mihizenithv/theremin-ieee-paper-repo/theremin-paper/docs/presentation_original.pdf

# THEREMIN

# Circuit

Using a 9V dc source and Pure Analog implementation

## IN SHORT:-

## “The circuit uses a CD4093-based RC oscillator with a potentiometer for frequency control, an op-amp for mixing and amplification, and an LM386 to drive an 8Ω speaker.”

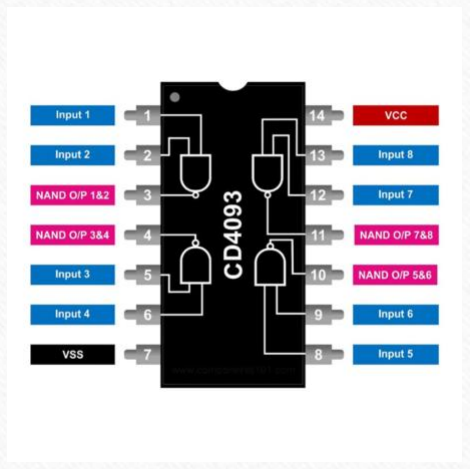
[picture p3: figure]

## COMPONENTS:-

CD4093
MCP602
LM386
Resistors (5.1k, 10k, 100k, 1M) Capacitors (100pF, 0.1µF, 10µF) 10k Potentiometer
Antenna
8Ω Speaker
7805 Ic
9V dc battery

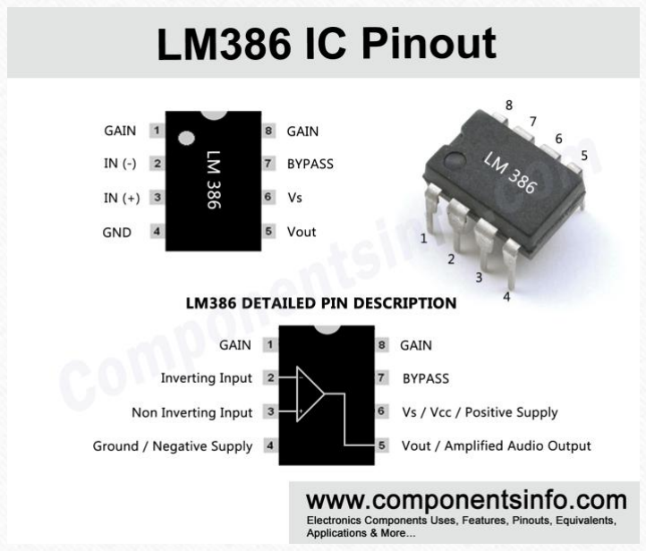
[picture p4: figure]

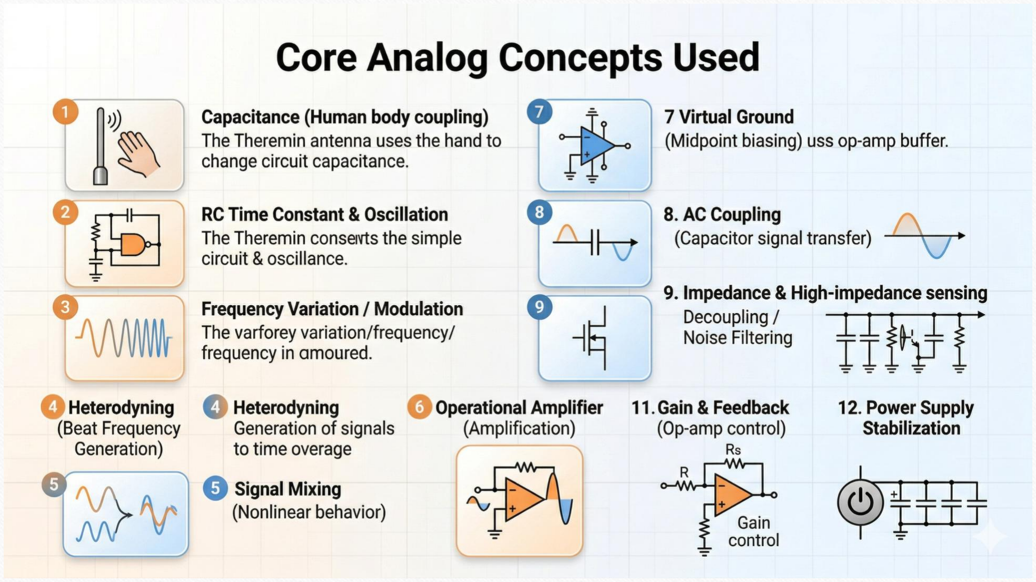
[picture p5: figure]

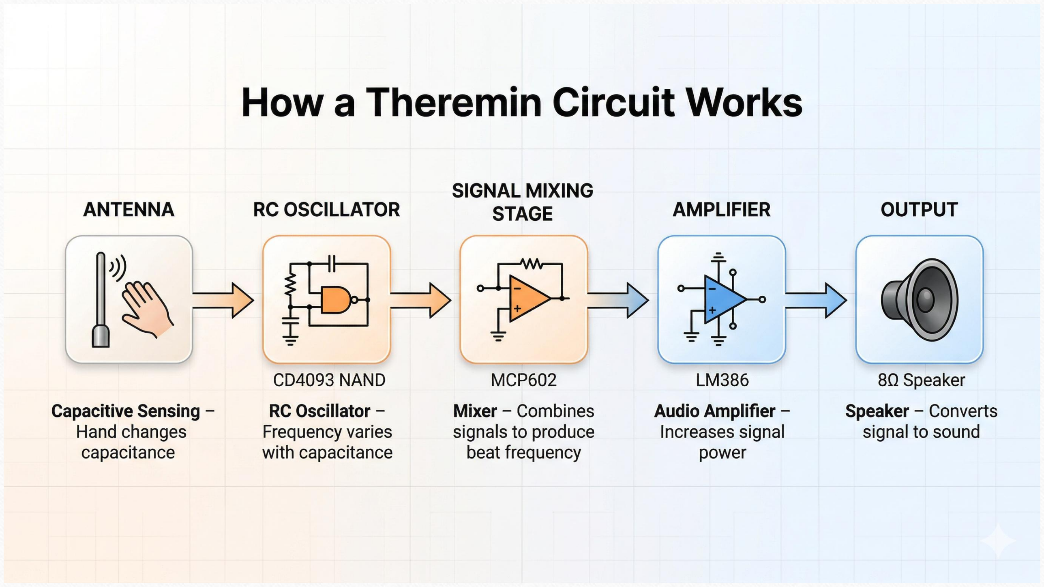
[picture p6: figure]
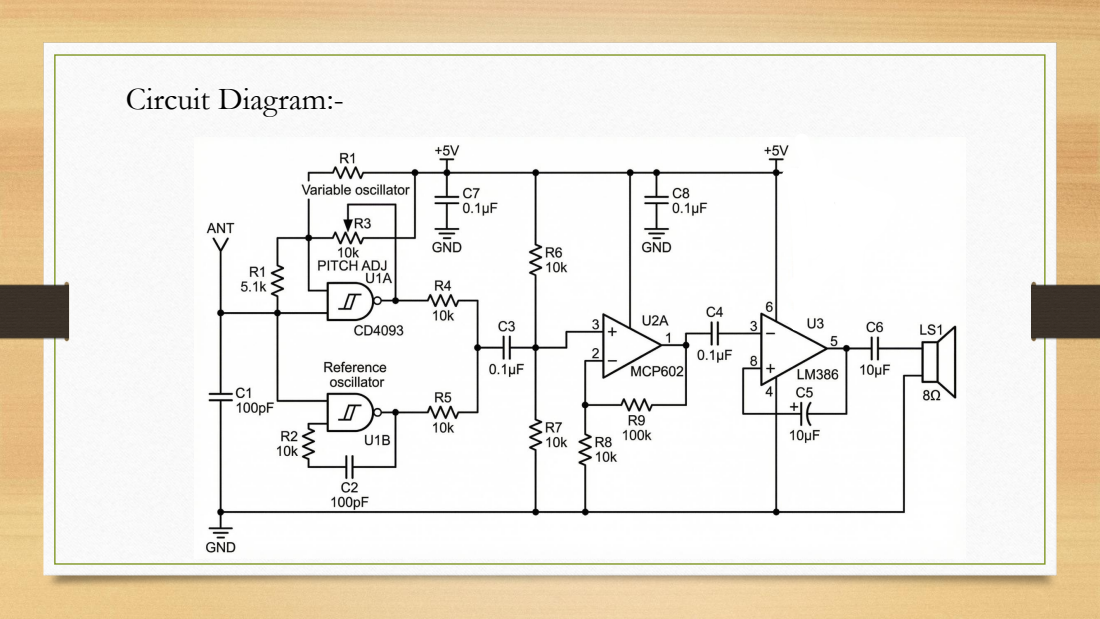
[picture p7: page 6]
Circuit Diagram:-

THE THEREMIN:-

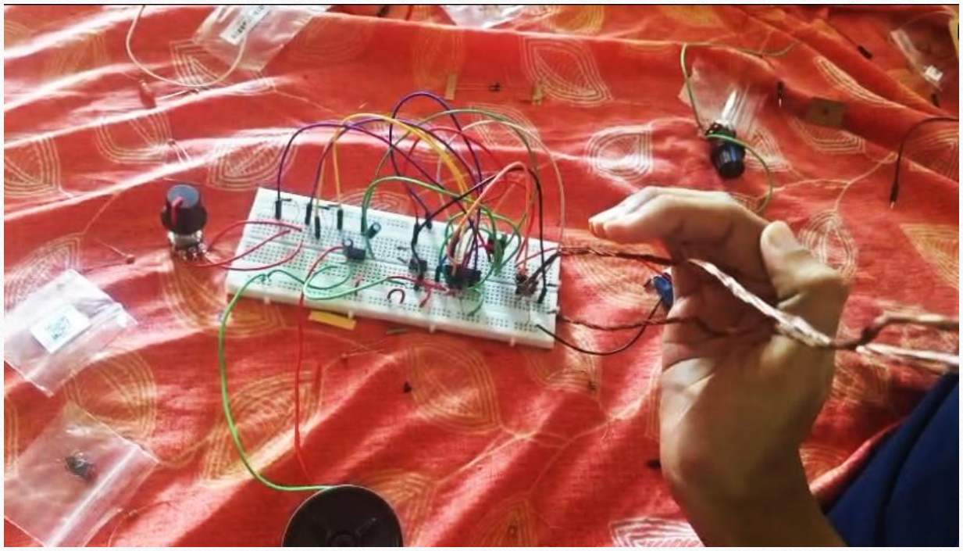
[picture p8: figure]
