mihizenithv/theremin-ieee-paper-repo/theremin-paper/paper/theremin_paper.pdf

# A Single-Package CMOS Heterodyne Theremin with Logic-Gate Mixing and Hybrid Potentiometer–Antenna Pitch Control

Chetansai Mihir P
Dept. of Electrical and
Electronics Engineering
Vellore Institute of Technology Vellore, India
mihirpuramsetti@gmail.com

Nainika Karthik
Dept. of Electrical and
Electronics Engineering
Vellore Institute of Technology Vellore, India
nainika.karthik@gmail.com

P Vigneshvaran
Dept. of Electrical and
Electronics Engineering
Vellore Institute of Technology Vellore, India
p.vigneshvaran2007@gmail.com

Rithikhaasree T
Dept. of Electrical and
Electronics Engineering
Vellore Institute of Technology Vellore, India
rithikhaathegreat@gmail.com

Abstract—A theremin is played without touch: the player’s hand forms a small, distance-dependent capacitance with an antenna, and a heterodyne (beat-frequency) circuit turns that sub-picofarad change into an audible pitch. Classical designs need hand-wound inductors and careful LC tuning. This paper presents an inductor-free theremin in which a single CD4093BE quad Schmitt-trigger NAND package performs every radiofrequency function: two matched ≈692 kHz RC oscillators, a logic-gate mixer, and a level-shifting inverter. An MCP602 Sallen– Key filter removes the carrier, and an LM386 drives an 8 Ω speaker, all from one 9 V battery through a 7805 regulator. We derive (i) an oscillator model that includes Schmitt thresholds, propagation delay and the resulting threshold overshoot, which shows that the common 1/(1.2RC) rule overestimates the frequency by 20%; (ii) a closed-form result showing that the filtered output of a logic-gate mixer is a triangle wave at the beat frequency with a peak-to-peak amplitude of VDDD, which sets the instrument’s timbre; and (iii) an antenna sensitivity of

### 3.9 kHz/pF. A hybrid potentiometer–antenna control scheme sets

the base pitch and keeps the oscillators away from their lockin region. A full-circuit SPICE simulation agrees with every analytical oscillator value to within 0.05%, and a breadboard prototype produced a smooth, continuous, contactless pitch response over a 5–25 cm hand range.
Index Terms—theremin, heterodyne, beat frequency, CD4093, Schmitt trigger, relaxation oscillator, capacitive sensing, logic-gate mixer, Sallen–Key filter, LM386
I. INTRODUCTION

The theremin, patented by L. S. Theremin in 1928 [1], is one of the very few instruments played without touch. The hand and a metal antenna form a capacitor of well under a picofarad to a few picofarads. That is far too small to change the pitch of an audio oscillator audibly, so the instrument runs two radiofrequency (RF) oscillators and listens to their difference. A tiny fractional change at RF then becomes a large change in the audible beat note [2]. Vacuum-tube and later transistor designs [3], [4] build these oscillators from LC tanks, which require inductors, careful layout and tuning.
This work asks how far the heterodyne theremin can be simplified while keeping solid engineering behind every stage. Starting from a two-IC hobbyist idea that uses CMOS Schmitt-trigger oscillators [5], we built a complete speaker-driving instrument with three ICs, no inductors and one 9 V battery. We also supply the analysis that such minimal designs usually lack.

Key contributions of this work

1) Single-package RF front end. All four gates of one CD4093BE are used: two oscillators, a mixer and an inverter. Both oscillators share one die and one supply, so their drift is common-mode and largely cancels in the beat note.
2) Analytic logic-mixer model. The filtered output of a NAND/AND mixer is shown to be a triangle wave at |fA − fB| with amplitude VDDD, with harmonics falling as 1/n²
. The inverter stage is shown to be necessary to keep this signal inside the op-amp’s input range.
3) Hybrid potentiometer–antenna pitch control. A pitch pot in the antenna oscillator zero-beats the instrument, sets a base note, and keeps the operating point on the side of zero beat where pitch rises monotonically, away from the injection-locking dead zone.
4) Portable single-supply design, verified in SPICE. One 9 V battery and a 7805 power every stage from one 5 V rail. Every design value is cross-checked against a full-circuit simulation.

Section II reviews theremin topologies, Section III presents the architecture, and Section IV analyses each stage. Sections V and VI cover the implementation and results, and Section VII discusses limitations.

II. BACKGROUND
In a heterodyne theremin, a variable oscillator at fA includes the hand capacitance Ch, and a reference oscillator runs at a fixed fB. A nonlinear mixer produces components at fA ± fB, and a low-pass filter keeps only the beat fb = |fA − fB|. The benefit is a relative-sensitivity gain:
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
. | (1)

At fA ≈ 692 kHz and fb = 1 kHz, a fractional change of the oscillator becomes a 692× larger fractional change of pitch.

TABLE I
COMPARISON OF THEREMIN TOPOLOGIES
Design | Oscillators | Mixer | Induc-
tors

Output

Theremin [1] Vacuum-tube
LC

Vacuum
tube
Yes | Speaker
Moog [3] | Transistor LC Transistor | Yes | Ext. ampli-
fier
Two-IC
idea [5]

CMOS
Schmitt RC
Op-amp | No | Line level
This work | CMOS
Schmitt RC,
one package

NAND gate
+ active filter

No 8 Ω
speaker,

### 9 V

battery

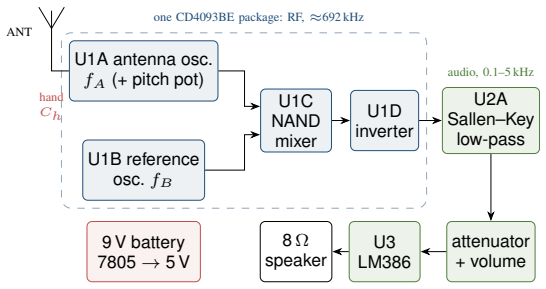
[picture p9: figure]
U1A antenna osc. fA (+ pitch pot); U1B reference osc. fB; U1C NAND mixer; U1D inverter; U2A Sallen–Key low-pass; attenuator + volume; 8 Ω speaker; 9 V battery 7805 → 5 V; ANT; hand Ch; one CD4093BE package: RF, ≈692 kHz; audio, 0.1–5 kHz

Fig. 1. System block diagram. All RF functions sit inside one CD4093BE; the audio chain uses one op-amp section and one power amplifier.

A single audio oscillator could only respond to picofarads if its timing capacitor were itself a few picofarads, which would need gigaohm resistors to reach audio frequencies and is not practical. Table I compares representative approaches.

III. SYSTEM ARCHITECTURE

Fig. 1 shows the signal chain and Fig. 2 the complete schematic, which is divided into six numbered blocks. Block 1 contains the antenna oscillator U1A, whose timing node is wired to the antenna, and the fixed reference oscillator U1B. In Block 2, gate U1C mixes the two square waves and U1D inverts the result. Block 3 is U2A, one half of the rail-torail MCP602, configured as a unity-gain second-order Sallen– Key low-pass filter [6], [7] that removes the carrier. Block 4 contains a fixed attenuator, the volume control and the LM386 amplifier, which drives the speaker. Blocks 5 and 6 hold the supply, the decoupling and the unused op-amp half.

IV. CIRCUIT DESIGN AND ANALYSIS

A. Schmitt-Trigger RC Oscillator

Each oscillator is a CD4093 gate with both inputs tied together, so it acts as a Schmitt inverter. A resistor feeds back from output to input, and a capacitor runs from input to ground [8]. The capacitor charges until it reaches the upper threshold VP and then discharges until it reaches the lower threshold VN . A simple analysis ignores the gate propagation delay tpd. During that delay, however, the capacitor keeps moving, so each half-cycle actually starts beyond the threshold, at

VH = VDD − (VDD − VP ) e

−tpd/τ , VL = VN e

−tpd/τ
,
(2)
where τ = (R + ro)C and ro is the gate’s output resistance. The period is then

T = τ

ln VDD − VL

VDD − VP

+ ln VH
VN
+ 2tpd. | (3)

With CD4093 typical values at VDD = 5 V (VP = 2.9 V, VN = 1.9 V, tpd = 190 ns, ro ≈ 400 Ω [9]), the reference oscillator (R2 = 10 kΩ, C2 = 100 pF) gives VH = 3.26 V, VL = 1.58 V and T = 1.445 µs, so fB = 692 kHz with a duty cycle of D = 48.2%.
The 1/(1.2RC) rule of thumb is 20% high. The widely quoted estimate gives 833 kHz here. It ignores both the delay and the overshoot it causes, and at this frequency they add ≈0.5 µs to a 1.4 µs period. Because the CD4093 is operating near its speed limit, delay makes up a large, device-dependent share of T. This is why the two oscillators must be matched on the same die (Section VII).
B. Antenna Sensitivity

The antenna connects directly to the timing node of U1A. Its self-capacitance, Cant ≈ 8 pF (an estimate for a short wire and lead), and the hand capacitance Ch both add to C1. Evaluating
(3) numerically at the zero-beat operating point gives

∂fA
∂C
≈ 3.9 kHz/pF, | (4)

so a change of 0.26 pF moves the pitch by 1 kHz. The naive estimate f ∆C/C used in many hobby write-ups, evaluated with the 833 kHz rule, gives 8.3 kHz/pF, which overstates the sensitivity by more than a factor of two.

C. Hybrid Potentiometer–Antenna Pitch Control

U1A’s feedback path is R1 = 5.1 kΩ in series with the 10 kΩ pitch pot RV1. With the hand absent, zero beat (fA = fB) occurs at RV1 = 4.13 kΩ, slightly below mid-travel. Over its full travel the pot sweeps fA from 0.94 to 0.51 MHz (Fig. 3b), which easily absorbs component tolerances and the unknown antenna capacitance. That is its first role.
Its second role is musical. Adding Ch always lowers fA. If the pot is set so that fA < fB with no hand present, an approaching hand widens the gap and the pitch rises monotonically. Turning the pot a little further sets a chosen base note, which the hand then bends upward (Fig. 3a). This offset also keeps the two oscillators away from exact zero beat. Near zero beat, two weakly coupled oscillators on a shared supply tend to injection-lock [10], which creates the silent “dead zone” familiar to theremin builders.
The pot’s tuning slope is |∂fA/∂RV1| = 43.5 Hz/Ω. On a 270◦
single-turn 10 kΩ pot, that is ≈1.6 kHz per degree, so the pot acts as a coarse control that the hand then refines.

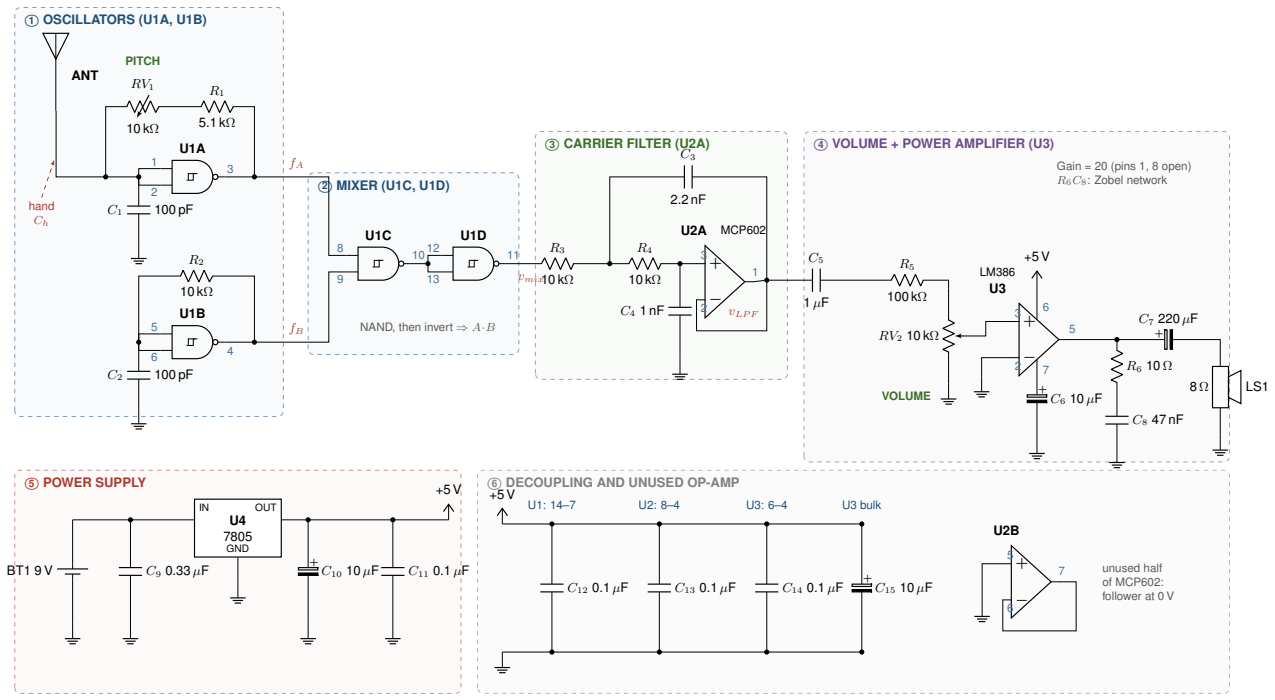
[picture p10: figure]
⃝1 OSCILLATORS (U1A, U1B); ⃝2 MIXER (U1C, U1D); ⃝5 POWER SUPPLY; ⃝6 DECOUPLING AND UNUSED OP-AMP; ANT; hand Ch; PITCH; NAND, then invert ⇒ A·B; vmix; U2A MCP602; vLP F; VOLUME; Gain = 20 (pins 1, 8 open) R6C8: Zobel network; OUT; GND; U3 bulk; unused half of MCP602: follower at 0 V

⃝3 CARRIER FILTER (U2A) | ⃝4 VOLUME + POWER AMPLIFIER (U3)

Fig. 2. Complete schematic. ⃝1 Antenna and reference oscillators (U1A, U1B). ⃝2 NAND mixer and inverter (U1C, U1D). ⃝3 Sallen–Key carrier filter (U2A). ⃝4 Attenuator, volume control and LM386 power amplifier. ⃝5 9 V battery and 7805 regulator. ⃝6 Supply decoupling and the unused MCP602 half. Blue numbers are IC pin numbers; red italic labels mark the signals analysed in Section IV.

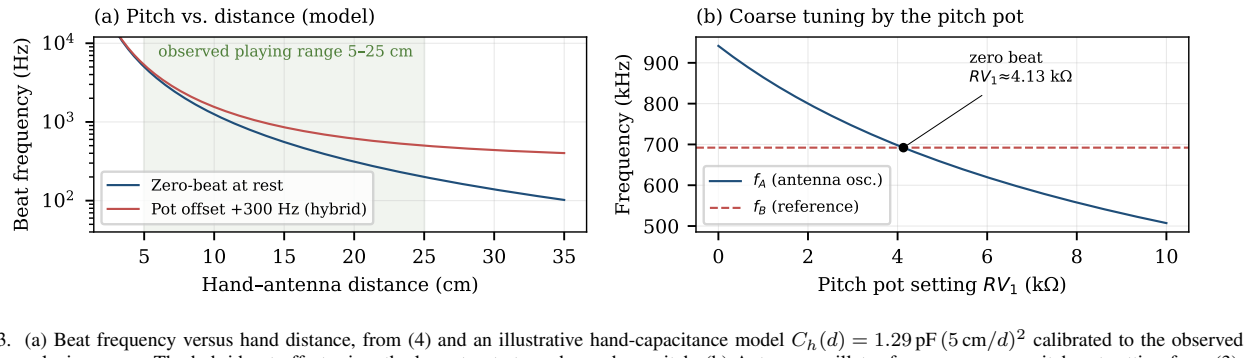
[picture p11: figure]
Hand antenna distance (cm); Beat frequency (Hz); observed playing range 5 25 cm; (a) Pitch vs. distance (model); Zero-beat at rest Pot offset +300 Hz (hybrid); Pitch pot setting RV1 (k ); Frequency (kHz); zero beat RV1 4.13 k; (b) Coarse tuning by the pitch pot; fA (antenna osc.) fB (reference); calibrated to the observed

Fig. 3. (a) Beat frequency versus hand distance, from (4) and an illustrative hand-capacitance model Ch(d) = 1.29 pF (5 cm/d)
5–25 cm playing range. The hybrid pot offset raises the lowest note to a chosen base pitch. (b) Antenna-oscillator frequency versus pitch-pot setting from (3); zero beat occurs at RV1 = 4.13 kΩ.
D. Logic-Gate Mixer
U1C forms A · B and U1D inverts it, giving A·B. Let θ(t) be the phase offset between the two square waves, measured as a fraction of one carrier period and wrapped to (−
1/2,

1/2]. This
offset advances steadily at the beat rate, θ = fbt. For a duty cycle D ≤
1/2, both inputs are high for a fraction max(0, D − |θ|) of each carrier period. Averaged over the carrier, the mixer output is therefore

v¯mix(t) = VDD max
0, D − |θ(t)|
, | (5)

which is a triangle wave at fb running from 0 to VDDD = 2.41 V. A triangle wave contains only odd harmonics, with amplitudes ∝ 1/n²
: the third is −19.1 dB and the fifth −28 dB relative to the fundamental, for a total harmonic distortion of 12%. This produces the soft, flute-like timbre of the instrument, and the timbre comes from the mixer itself rather than from a separate waveshaper.

Why the inverter U1D is needed. The raw NAND output of U1C would average between VDD(1 − D) = 2.59 V and 5 V. That exceeds the MCP602’s input common-mode limit of VDD − 1.2 = 3.8 V [11], so the waveform would be clipped. Inverting it moves the signal down to 0–2.41 V, safely inside the valid range. The otherwise spare fourth gate therefore works as an exact level shifter at no extra cost.

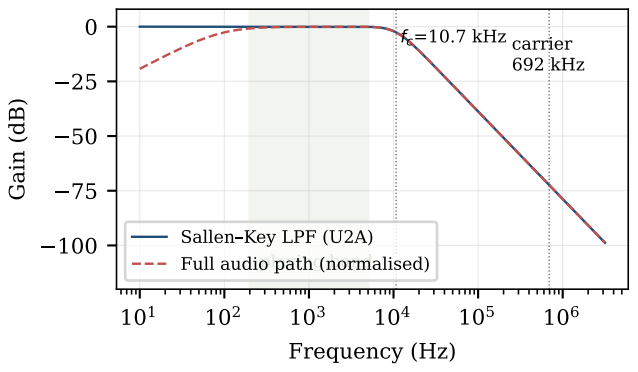
[picture p12: figure]
Frequency (Hz); Gain (dB); fc=10.7 kHz; carrier; kHz; Full audio path (normalised); playing band; Sallen Key LPF (U2A)

Fig. 4. Frequency response of the Sallen–Key filter alone and of the full audio path including the C5 and C7 coupling networks (normalised). The shaded band is the playing range.

E. Carrier Filter (U2A)
The unity-gain Sallen–Key filter uses R3 = R4 = 10 kΩ, C3 = 2.2 nF (feedback) and C4 = 1 nF (to ground), which gives

fc =

1
2πR√
C3C4

= 10.7 kHz, Q =

1
2

r
C3
C4

= 0.74.

(6)
The response is flat over the 0.1–5 kHz playing band and attenuates the 692 kHz carrier by 72 dB in the ideal model (Fig. 4). At the carrier, the op-amp’s finite output impedance sets a real stopband floor. However, the LM386’s bandwidth and the loudspeaker suppress any residue further.
F. Output Stage
C5 (1 µF) blocks the 1.2 V DC level of the triangle. Its time constant with the 108 kΩ load is 0.11 s, so the output settles quickly at switch-on, and the high-pass corner of 1.5 Hz leaves the audio untouched. R5 = 100 kΩ and the 10 kΩ volume pot RV2, in parallel with the LM386’s 50 kΩ input, form a 1:13 attenuator. At full volume the amplifier input is therefore 0.19 V p-p, and at the LM386’s default gain of 20 (pins 1 and 8 open [12]) this reaches the ≈3.6 V p-p output limit at 5 V. The volume pot can thus use its full travel without heavily overdriving the amplifier. C7 = 220 µF couples the 8 Ω speaker with a 90 Hz high-pass corner. The Zobel network R6C8 and the pin-7 bypass C6 follow the datasheet recommendations [12].
G. Power Supply
A 7805 [13] regulates the 9 V battery to 5 V for all three ICs, with C9 = 0.33 µF at its input as the datasheet recommends. A regulated rail keeps the CD4093 thresholds and delays, and therefore fA and fB, independent of battery discharge. Each IC has a 0.1 µF decoupling capacitor, and the LM386 has an extra 10 µF bulk capacitor. Table II gives the estimated budget. Consumption is about 11 mA at idle and roughly 50 mA during typical playing, which gives an estimated 6–10 h from a 9 V alkaline cell. Regulation holds until the battery falls to about 7 V (the 7805’s 2 V dropout).

TABLE II
ESTIMATED POWER BUDGET (5 V RAIL, 9 V BATTERY)
Block | Current Basis

CD4093BE, 4 gates at ≈0.7 MHz ≈1.5 mA estimate (CV ²f + RC)
MCP602, both halves | 0.46 mA 230 µA/amp typ. [11]
LM386 quiescent | 4 mA typ. [12]
7805 quiescent | ≈5 mA typ. [13]
Idle total | ≈11 mA ≈0.1 W from 9 V
Speaker at moderate volume | ≈40 mA estimate
Typical playing | ≈50 mA 7805 dissipates ≈0.2 W

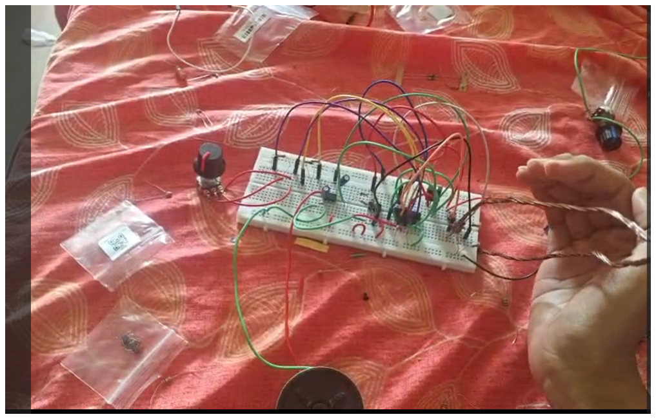
[picture p13: figure]

Fig. 5. Breadboard prototype being played. The twisted-wire antenna (right, beside the hand), pitch potentiometer, the three ICs and the 8 Ω speaker (bottom) are visible.

V. IMPLEMENTATION

The prototype was built on a solderless breadboard (Fig. 5). A twisted copper-wire lead serves as the pitch antenna, and there is a panel potentiometer for pitch and a second for volume. Table III lists the parts. The two 100 pF timing capacitors should be matched C0G/NP0 ceramics, so that zero beat falls inside the pot’s range and stays put as temperature changes.
Tuning procedure. (1) Switch on with hands at least 50 cm from the antenna. (2) Turn RV1 slowly until the tone sweeps down through zero beat, which is heard as a low growl that falls silent. (3) Continue a few degrees in the direction in which an approaching hand makes the pitch rise, and stop at the desired base note. (4) Set the level with RV2.

VI. RESULTS

A. Full-Circuit SPICE Verification
Because no bench instruments were available during the build, the complete netlist of Fig. 2 was simulated in ngspice. The model uses behavioural CD4093 gates with datasheet thresholds, a 190 ns delay and 400 Ω outputs, an MCP602 macromodel (2.8 MHz GBW, rail-to-rail output) and an LM386 model (gain 20, 50 kΩ inputs). Table IV compares the hand analysis with the simulation, and they agree to within 0.05% on every oscillator value. With RV1 set 23 Ω above zero beat, which by the 43.5 Hz/Ω slope should give 1.00 kHz,

TABLE III
BILL OF MATERIALS
Ref. | Value / part | Function
U1 | CD4093BE | Oscillators, mixer, inverter
U2 | MCP602 | Sallen–Key filter; U2B unused
U3 | LM386 | Speaker amplifier, gain 20
U4 | 7805 | 5 V regulator
R1, RV1 | 5.1 kΩ, 10 kΩ pot | Antenna-osc. timing; pitch
R2 | 10 kΩ | Reference-osc. timing
C1, C2 | 100 pF C0G | Oscillator timing (matched)
R3, R4 | 10 kΩ | Sallen–Key resistors
C3, C4 | 2.2 nF, 1 nF | Sallen–Key capacitors
C5 | 1 µF film | DC block
R5, RV2 | 100 kΩ, 10 kΩ pot | Attenuator; volume
C6, C7 | 10 µF, 220 µF elec. LM386 bypass; speaker cou-
| | pling
R6, C8 | 10 Ω, 47 nF | Zobel network
C9 | 0.33 µF | Regulator input
C10, C15 | 10 µF elec. | Regulator output; U3 bulk
C11–C14 | 0.1 µF | Rail and IC decoupling
ANT, LS1, BT1 wire, 8 Ω, 9 V | Antenna, speaker, battery

TABLE IV
HAND ANALYSIS VERSUS FULL-CIRCUIT SPICE SIMULATION
Quantity | Analysis | SPICE
Reference frequency fB | 692.1 kHz | 692.2 kHz
fA at RV1 = 0 | 941.6 kHz | 941.3 kHz
fA at RV1 = 2 kΩ | 800.1 kHz | 799.8 kHz
fA at RV1 = 4.16 kΩ | 690.8 kHz | 690.6 kHz
Beat at RV1 = 4.153 kΩ | 1.00 kHz | 1.00 kHz
U2A output range | 0–2.41 V 0.02–2.39 V
U2A output mean | 1.20 V | 1.16 V
Speaker, full volume | ≤3.6 V p-p | 2.7 V p-p

the simulated beat is exactly 1.00 kHz. Fig. 6 shows the waveforms: the carriers, the AND-gate output, the recovered triangle, and the speaker voltage.
The spectrum in Fig. 7 confirms the triangle-wave prediction: the third harmonic is 19.2 dB below the fundamental, matching the 1/n²
law, and the carrier is suppressed by about 70 dB.
B. Experimental Observations

Powered from a 9 V battery, the breadboard prototype behaved as the analysis predicts:

- A steady tone was heard at power-up, confirming that both oscillators were running with the beat in the audible range.
- Moving a hand toward the antenna raised the pitch, and moving it away lowered the pitch. The change was smooth and continuous, with no audible steps, over roughly 5–25 cm from the antenna.
- The pitch pot set the base note, and changing the volume did not shift the pitch.
- AC coupling at the speaker removed the DC offset and clearly improved sound quality compared with a direct connection.

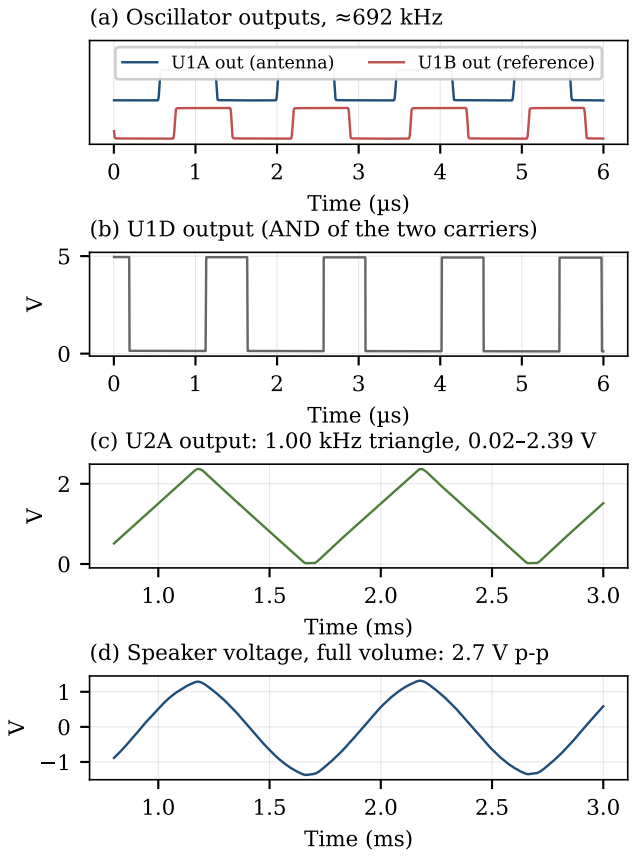
[picture p14: figure]
Time (µs); (a) Oscillator outputs,; 692 kHz; U1A out (antenna); U1B out (reference); Time (ms)

(b) U1D output (AND of the two carriers)
(c) U2A output: 1.00 kHz triangle, 0.02 2.39 V
(d) Speaker voltage, full volume: 2.7 V p-p

Fig. 6. Full-circuit SPICE waveforms. (a) Oscillator outputs. (b) AND-gate (U1D) output, whose pulse width tracks the phase difference. (c) U2A output: a 1.00 kHz triangle, as predicted by (5). (d) Speaker voltage at full volume, slightly rounded as the LM386 approaches its output limit.

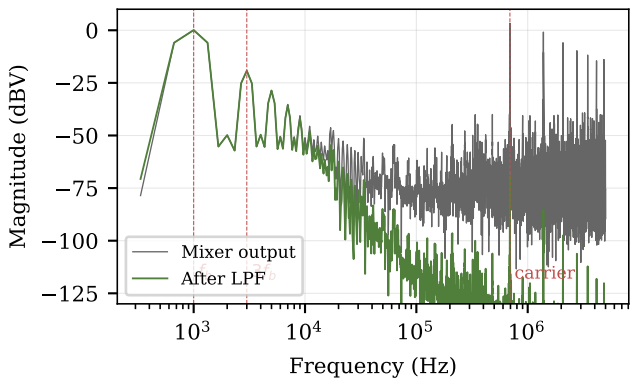
[picture p15: figure]
Frequency (Hz); Magnitude (dBV); carrier; Mixer output; After LPF

Fig. 7. Spectra of the mixer output and the filtered output. The beat fundamental and its odd harmonics pass, and the carrier cluster near 692 kHz is removed.

- Long battery leads caused slight pitch drift, and nearby metal objects shifted the base pitch. Both effects follow from (4), as discussed below.
Fig. 3(a) shows the pitch–distance relation implied by (4). Because the hand-capacitance law depends on geometry, that curve is a calibrated model, not a measurement.

VII. DISCUSSION
Common-mode drift cancellation. By (3), each frequency depends on VP , VN , tpd and ro, and all of these vary with temperature and from device to device. The CD4093 datasheet allows VP anywhere from 2.2 to 3.6 V at 5 V [9]. On two separate chips, this spread could shift the two frequencies by tens of percent relative to each other, which no pot could null. On one die the variations are common-mode, and because only fA − fB is heard, first-order drift cancels.
Environmental sensitivity. At 3.9 kHz/pF, a stray change of only 0.03 pF, such as a lead moving a few millimetres, shifts the pitch by about 100 Hz. This explains the observed sensitivity to battery-lead length and to nearby metal. Short, fixed wiring and a grounded enclosure are the practical remedies. Limitations. (i) Tuning with a single-turn pot is coarse, at about 1.6 kHz per degree. (ii) The hybrid offset reduces injection locking near zero beat but does not eliminate it. (iii) The linear regulator wastes about 44% of the battery power. (iv) There is no volume antenna, so loudness is set by hand.
(v) The quantitative results come from simulation, and bench measurements remain to be done.

VIII. CONCLUSION AND FUTURE WORK
We have presented a three-IC, inductor-free heterodyne theremin in which one CD4093BE performs every RF function. Closed-form models explain its operating frequency, antenna sensitivity, playing range and triangle-wave timbre, and a full-circuit SPICE simulation confirms the oscillator values to within 0.05%. The analysis also shows two design constraints that are easy to miss: the inverter stage is needed to respect the op-amp’s input range, and the oscillators must be matched on a single die. The hybrid pot–antenna control and the single 9 V supply make the instrument practical and portable. Future work includes bench measurements with an oscilloscope and spectrum analyser, a multi-turn or varactor fine-tuning control, a second antenna for volume, a lowdropout regulator, and a PCB with a guarded antenna trace.

ACKNOWLEDGMENT
The authors thank Dr. Jitendra Goyal for his guidance and support. This work was carried out as part of the analog electronics curriculum at Vellore Institute of Technology, Vellore.

REFERENCES

[1] L. S. Theremin, “Method of and apparatus for the generation of sounds,” U.S. Patent 1 661 058, Feb. 28, 1928.
[2] K. D. Skeldon, L. M. Reid, V. McInally, B. Dougan, and C. Fulton, “Physics of the Theremin,” Amer. J. Phys., vol. 66, no. 11,
pp. 945–955, Nov. 1998.
[3] R. A. Moog, “A transistorized theremin,” Electronics World, Jan. 1961.
[4] A. Glinsky, Theremin: Ether Music and Espionage. Urbana, IL, USA: Univ. of Illinois Press, 2000.
[5] GreatScottLab, “Make your own simple theremin,” Instructables. [Online]. Available:
https://www.instructables.com/Make-Your-Own-Simple-Theremin/
[6] R. P. Sallen and E. L. Key, “A practical method of designing RC active filters,” IRE Trans. Circuit Theory, vol. CT-2, no. 1, pp. 74–85, Mar. 1955.
[7] S. Franco, Design With Operational Amplifiers and Analog Integrated Circuits, 4th ed. New York, NY, USA: McGraw-Hill, 2015.
[8] P. Horowitz and W. Hill, The Art of Electronics, 3rd ed. Cambridge, U.K.: Cambridge Univ. Press, 2015.
[9] Texas Instruments, “CD4093B types: CMOS quad 2-input NAND Schmitt triggers,” datasheet. [Online]. Available: https://www.ti.com/lit/ds/symlink/cd4093b.pdf
[10] R. Adler, “A study of locking phenomena in oscillators,” Proc. IRE, vol. 34, no. 6, pp. 351–357, Jun. 1946.
[11] Microchip Technology, “MCP601/1R/2/3/4: 2.7 V to 6.0 V single supply CMOS op amps,” datasheet DS21314. [Online]. Available: https://www.microchip.com/en-us/product/MCP602
[12] Texas Instruments, “LM386 low voltage audio power amplifier,” datasheet. [Online]. Available: https://www.ti.com/lit/ds/symlink/lm386.pdf
[13] Texas Instruments, “LM340, LM340A and LM7805 family wide VIN 1.5-A fixed voltage regulators,” datasheet. [Online]. Available: https://www.ti.com/lit/ds/symlink/lm7800.pdf
