mihizenithv/theremin-ieee-paper-repo/theremin-paper/paper/figs/waveforms.pdf

0

5

V

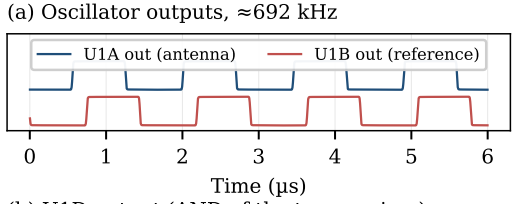
[picture p16: figure]
Time (µs); (a) Oscillator outputs,; 692 kHz; U1A out (antenna); U1B out (reference)

(b) U1D output (AND of the two carriers)

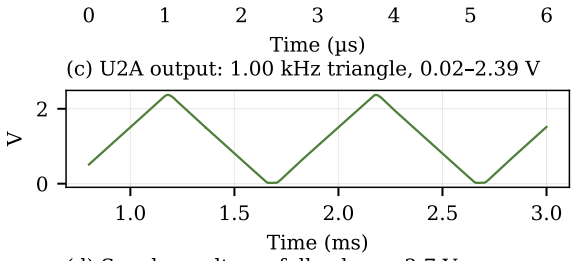
[picture p17: figure]
Time (µs); Time (ms)

(c) U2A output: 1.00 kHz triangle, 0.02 2.39 V
(d) Speaker voltage, full volume: 2.7 V p-p

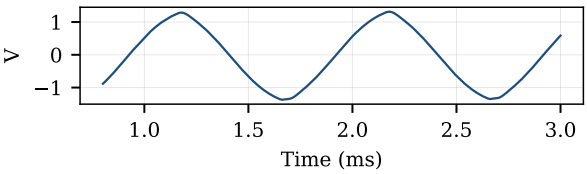
[picture p18: figure]
Time (ms)
