mihizenithv/theremin-ieee-paper-repo/theremin-paper/paper/figs/bode.pdf

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

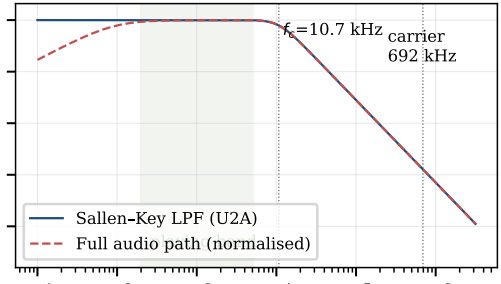
[picture p19: figure]
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
