mihizenithv/theremin-ieee-paper-repo/theremin-paper/paper/figs/pitch.pdf

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

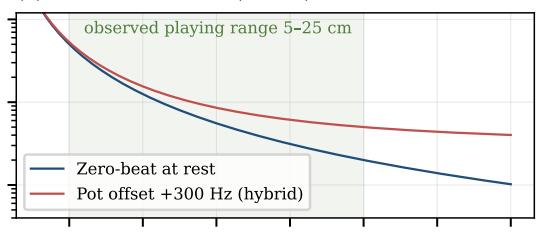
[picture p20: figure]
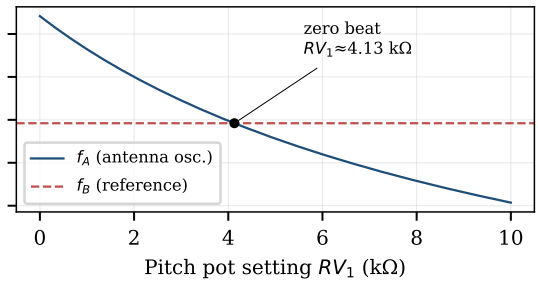
[picture p21: figure]
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
