mihizenithv/theremin-ieee-paper-repo/theremin-paper/schematic/schematic.pdf

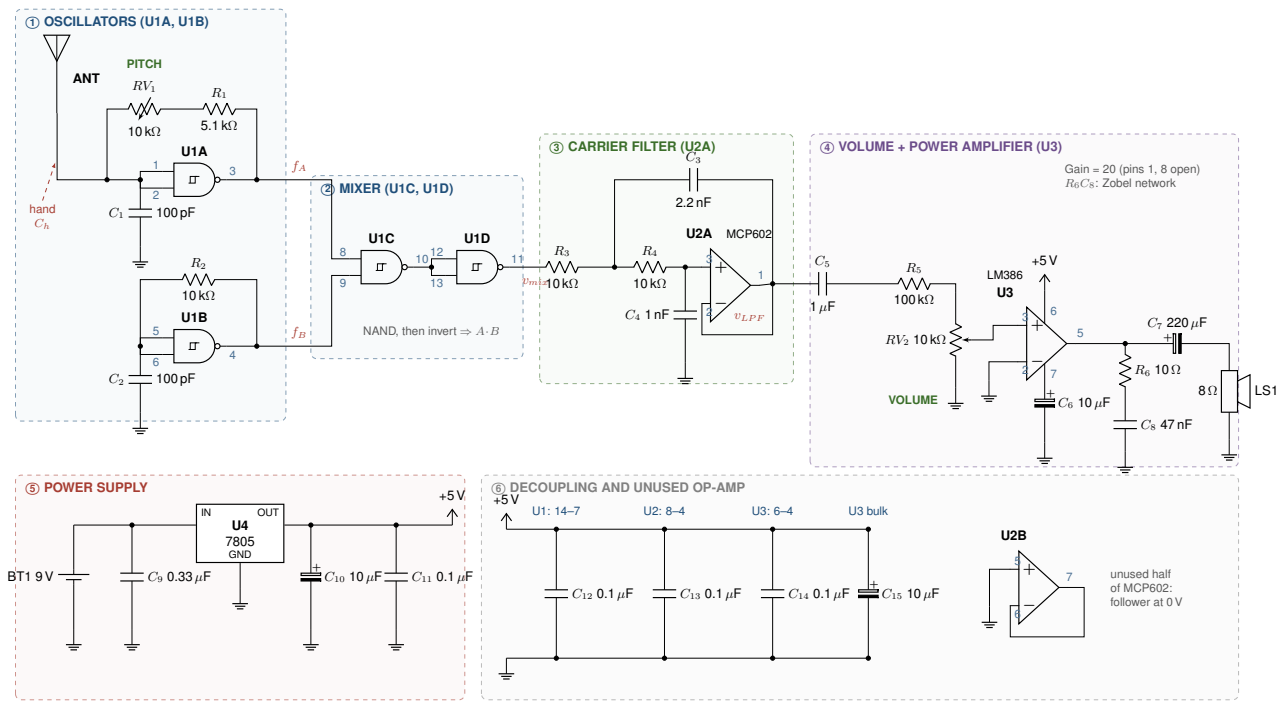
[picture p22: page 1]
